Hmouse666/ges-arm/sim/simulation.png

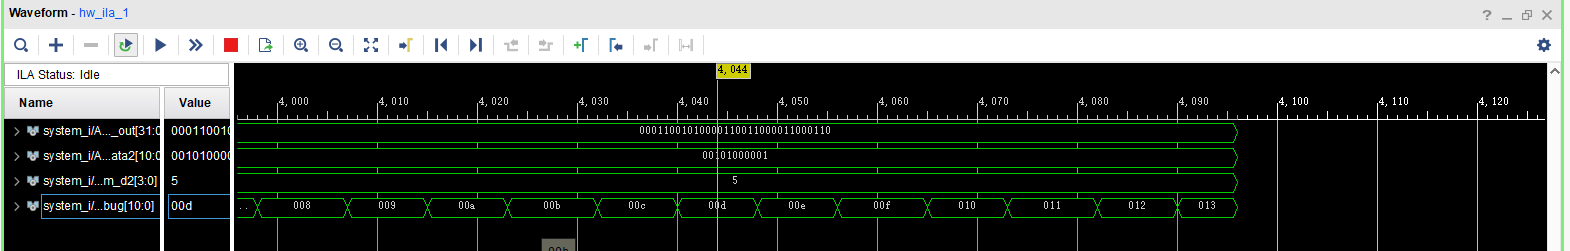
sim/simulation.png
