Hmouse666/ges-arm/src/ps/app/display_ctrl/display_ctrl.c

/************************************************************************/
/*																		*/
/*	display_ctrl.c	--	Digilent Display Controller Driver				*/
/*																		*/
/************************************************************************/
/*	Author: Sam Bobrowicz												*/
/*	Copyright 2014, Digilent Inc.										*/
/************************************************************************/
/*  Module Description: 												*/
/*																		*/
/*		This module provides an easy to use API for controlling a    	*/
/*		Display attached to a Digilent system board via VGA or HDMI. 	*/
/*		run-time resolution setting and seamless framebuffer-swapping 	*/
/*		for tear-free animation. 										*/
/*																		*/
/*		To use this driver, you must have a Xilinx Video Timing 		*/
/* 		Controller core (vtc), Xilinx axi_vdma core, a Digilent 		*/
/*		axi_dynclk core, a Xilinx AXI Stream to Video core, and either  */
/*		a Digilent RGB2VGA or RGB2DVI core all present in your design.  */
/*		See the Video in or Display out reference projects for your     */
/*		system board to see how they need to be connected. Digilent     */
/*		reference projects and IP cores can be found at 				*/
/*		www.github.com/Digilent.			 							*/
/*																		*/
/*		The following steps should be followed to use this driver:		*/
/*		1) Create a DisplayCtrl object and pass a pointer to it to 		*/
/*		   DisplayInitialize.											*/
/*		2) Call DisplaySetMode to set the desired mode					*/
/*		3) Call DisplayStart to begin outputting data to the display	*/
/*		4) To create a seamless animation, draw the next image to a		*/
/*		   framebuffer currently not being displayed. Then call 		*/
/*		   DisplayChangeFrame to begin displaying that frame.			*/
/*		   Repeat as needed, only ever modifying inactive frames.		*/
/*		5) To change the resolution, call DisplaySetMode, followed by	*/
/*		   DisplayStart again.											*/
/*																		*/
/*																		*/
/************************************************************************/
/*  Revision History:													*/
/* 																		*/
/*		2/20/2014(SamB): Created										*/
/*		11/25/2015(SamB): Changed from axi_dispctrl to Xilinx cores		*/
/*						  Separated Clock functions into dynclk library */
/*																		*/
/************************************************************************/
/*
 * TODO: It would be nice to remove the need for users above this to access
 *       members of the DisplayCtrl struct manually. This can be done by
 *       implementing get/set functions for things like video mode, state,
 *       etc.
 */


/* ------------------------------------------------------------ */
/*				Include File Definitions						*/
/* ------------------------------------------------------------ */

/*
 * Uncomment for Debugging messages over UART
 */
//#define DEBUG

#include "display_ctrl.h"
#include "xdebug.h"
#include "xil_io.h"

/* ------------------------------------------------------------ */
/*				Procedure Definitions							*/
/* ------------------------------------------------------------ */

/***	DisplayStop(DisplayCtrl *dispPtr)
**
**	Parameters:
**		dispPtr - Pointer to the initialized DisplayCtrl struct
**
**	Return Value: int
**		XST_SUCCESS if successful.
**		XST_DMA_ERROR if an error was detected on the DMA channel. The
**			Display is still successfully stopped, and the error is
**			cleared so that subsequent DisplayStart calls will be
**			successful. This typically indicates insufficient bandwidth
**			on the AXI Memory-Map Interconnect (VDMA<->DDR)
**
**	Description:
**		Halts output to the display
**
*/
int DisplayStop(DisplayCtrl *dispPtr)
{
	/*
	 * If already stopped, do nothing
	 */
	if (dispPtr->state == DISPLAY_STOPPED)
	{
		return XST_SUCCESS;
	}

	/*
	 * Disable the disp_ctrl core, and wait for the current frame to finish (the core cannot stop
	 * mid-frame)
	 */
	XVtc_DisableGenerator(&dispPtr->vtc);

	/*
	 * Update Struct state
	 */
	dispPtr->state = DISPLAY_STOPPED;

	//TODO: consider stopping the clock here, perhaps after a check to see if the VTC is finished

	return XST_SUCCESS;
}
/* ------------------------------------------------------------ */

/***	DisplayStart(DisplayCtrl *dispPtr)
**
**	Parameters:
**		dispPtr - Pointer to the initialized DisplayCtrl struct
**
**	Return Value: int
**		XST_SUCCESS if successful, XST_FAILURE otherwise
**
**	Errors:
**
**	Description:
**		Starts the display.
**
*/
int DisplayStart(DisplayCtrl *dispPtr)
{
	XVtc_Timing vtcTiming;
	XVtc_SourceSelect SourceSelect;

	xdbg_printf(XDBG_DEBUG_GENERAL, "display start entered\n\r");
	/*
	 * If already started, do nothing
	 */
	if (dispPtr->state == DISPLAY_RUNNING)
	{
		return XST_SUCCESS;
	}

	/*
	 * Configure the vtc core with the display mode timing parameters
	 */
	vtcTiming.HActiveVideo = dispPtr->vMode.width;	/**< Horizontal Active Video Size */
	vtcTiming.HFrontPorch = dispPtr->vMode.hps - dispPtr->vMode.width;	/**< Horizontal Front Porch Size */
	vtcTiming.HSyncWidth = dispPtr->vMode.hpe - dispPtr->vMode.hps;		/**< Horizontal Sync Width */
	vtcTiming.HBackPorch = dispPtr->vMode.hmax - dispPtr->vMode.hpe + 1;		/**< Horizontal Back Porch Size */
	vtcTiming.HSyncPolarity = dispPtr->vMode.hpol;	/**< Horizontal Sync Polarity */
	vtcTiming.VActiveVideo = dispPtr->vMode.height;	/**< Vertical Active Video Size */
	vtcTiming.V0FrontPorch = dispPtr->vMode.vps - dispPtr->vMode.height;	/**< Vertical Front Porch Size */
	vtcTiming.V0SyncWidth = dispPtr->vMode.vpe - dispPtr->vMode.vps;	/**< Vertical Sync Width */
	vtcTiming.V0BackPorch = dispPtr->vMode.vmax - dispPtr->vMode.vpe + 1;;	/**< Horizontal Back Porch Size */
	vtcTiming.V1FrontPorch = dispPtr->vMode.vps - dispPtr->vMode.height;	/**< Vertical Front Porch Size */
	vtcTiming.V1SyncWidth = dispPtr->vMode.vpe - dispPtr->vMode.vps;	/**< Vertical Sync Width */
	vtcTiming.V1BackPorch = dispPtr->vMode.vmax - dispPtr->vMode.vpe + 1;;	/**< Horizontal Back Porch Size */
	vtcTiming.VSyncPolarity = dispPtr->vMode.vpol;	/**< Vertical Sync Polarity */
	vtcTiming.Interlaced = 0;		/**< Interlaced / Progressive video */

	/* Setup the VTC Source Select config structure. */
	/* 1=Generator registers are source */
	/* 0=Detector registers are source */
	memset((void *)&SourceSelect, 0, sizeof(SourceSelect));
	SourceSelect.VBlankPolSrc = 1;
	SourceSelect.VSyncPolSrc = 1;
	SourceSelect.HBlankPolSrc = 1;
	SourceSelect.HSyncPolSrc = 1;
	SourceSelect.ActiveVideoPolSrc = 1;
	SourceSelect.ActiveChromaPolSrc= 1;
	SourceSelect.VChromaSrc = 1;
	SourceSelect.VActiveSrc = 1;
	SourceSelect.VBackPorchSrc = 1;
	SourceSelect.VSyncSrc = 1;
	SourceSelect.VFrontPorchSrc = 1;
	SourceSelect.VTotalSrc = 1;
	SourceSelect.HActiveSrc = 1;
	SourceSelect.HBackPorchSrc = 1;
	SourceSelect.HSyncSrc = 1;
	SourceSelect.HFrontPorchSrc = 1;
	SourceSelect.HTotalSrc = 1;

	XVtc_SelfTest(&(dispPtr->vtc));

	XVtc_RegUpdateEnable(&(dispPtr->vtc));
	XVtc_SetGeneratorTiming(&(dispPtr->vtc), &vtcTiming);
	XVtc_SetSource(&(dispPtr->vtc), &SourceSelect);
    /*
	 * Enable VTC core, releasing backpressure on VDMA
	 */
	XVtc_EnableGenerator(&dispPtr->vtc);

	dispPtr->state = DISPLAY_RUNNING;

	return XST_SUCCESS;
}

/* ------------------------------------------------------------ */

/***	DisplayInitialize(DisplayCtrl *dispPtr,u16 vtcId)
**
**	Parameters:
**		dispPtr - Pointer to the struct that will be initialized
**		vtcId - Device ID of the VTC core as found in xparameters.h
**
**	Return Value: int
**		XST_SUCCESS if successful, XST_FAILURE otherwise
**
**	Errors:
**
**	Description:
**		Initializes the driver struct for use.
**
*/
  int DisplayInitialize(DisplayCtrl *dispPtr, u16 vtcId)
{
	int Status;
	XVtc_Config *vtcConfig;

	/*
	 * Initialize all the fields in the DisplayCtrl struct
	 */
	dispPtr->state = DISPLAY_STOPPED;
	dispPtr->vMode = VMODE_800x480;

	/* Initialize the VTC driver so that it's ready to use look up
	 * configuration in the config table, then initialize it.
	 */
	vtcConfig = XVtc_LookupConfig(vtcId);
	/* Checking Config variable */
	if (NULL == vtcConfig) {
		return (XST_FAILURE);
	}
	Status = XVtc_CfgInitialize(&(dispPtr->vtc), vtcConfig, vtcConfig->BaseAddress);
	/* Checking status */
	if (Status != (XST_SUCCESS)) {
		return (XST_FAILURE);
	}

	return XST_SUCCESS;
}
/* ------------------------------------------------------------ */

/***	DisplaySetMode(DisplayCtrl *dispPtr, const VideoMode *newMode)
**
**	Parameters:
**		dispPtr - Pointer to the initialized DisplayCtrl struct
**		newMode - The VideoMode struct describing the new mode.
**
**	Return Value: int
**		XST_SUCCESS if successful, XST_FAILURE otherwise
**
**	Errors:
**
**	Description:
**		Changes the resolution being output to the display. If the display
**		is currently started, it is automatically stopped (DisplayStart must
**		be called again).
**
*/
int DisplaySetMode(DisplayCtrl *dispPtr, const VideoMode *newMode)
{
	int Status;

	/*
	 * If currently running, stop
	 */
	if (dispPtr->state == DISPLAY_RUNNING)
	{
		Status = DisplayStop(dispPtr);
		if (Status != XST_SUCCESS)
		{
			xdbg_printf(XDBG_DEBUG_GENERAL, "Cannot change mode, unable to stop display %d\r\n", Status);
			return XST_FAILURE;
		}
	}

	dispPtr->vMode = *newMode;

	return XST_SUCCESS;
}

/*****************************************************************************/
/**
* 读取 LCD ID:AXI GPIO 通道上的 3 位输入,对应 LCD 接口 R7/G7/B7 的识别电平。
* 返回值与正点原子例程一致,用于判断接的是哪种屏:
*	0x4342 = 4.3寸 480x272		0x4384 = 4.3寸 800x480
*	0x7084 = 7寸   800x480		0x7016 = 7寸   1024x600
*	0x1018 = 10.1寸 1280x800
*
* @param	axi_gpio_inst 已初始化好的 AXI GPIO 实例
* @param	chanel        AXI GPIO 通道(LCD ID 用的是通道 1)
*
* @return	LCD ID,读到未知数值时返回 0
*
*/
u16 lcd_id_read(XGpio * axi_gpio_inst, unsigned chanel)
{
	u32 idx = 0;

	idx = XGpio_DiscreteRead(axi_gpio_inst, chanel);

	switch (idx)
	{
	case 0:  return 0x4342;
	case 1:  return 0x7084;
	case 2:  return 0x7016;
	case 4:  return 0x4384;
	case 5:  return 0x1018;
	default: return 0;
	}
}
