Hmouse666/ges-arm/src/stm32/tkkc_drivers/task_common.c

/**
  ******************************************************************************
  * @file    task_common.c
  * @brief   原来的共用手势控制已迁移到 task1.c
  *
  * 本文件保留为空, 不再参与工程编译。
  ******************************************************************************
  */
