Hmouse666/ges-arm/(notices)

Notices in the files:
src/stm32/core/src/usart.c:
Copyright (c) 2026 STMicroelectronics.
All rights reserved.
This software is licensed under terms that can be found in the LICENSE file
src/fpga/ip_repo/ov5640_capture_data/src/ov5640_capture_data.v:
Copyright(C) ÕýµãÔ­×Ó 2023-2033
